gabrielaportomachado/ENGN1600-Project/plots/full_allon.png

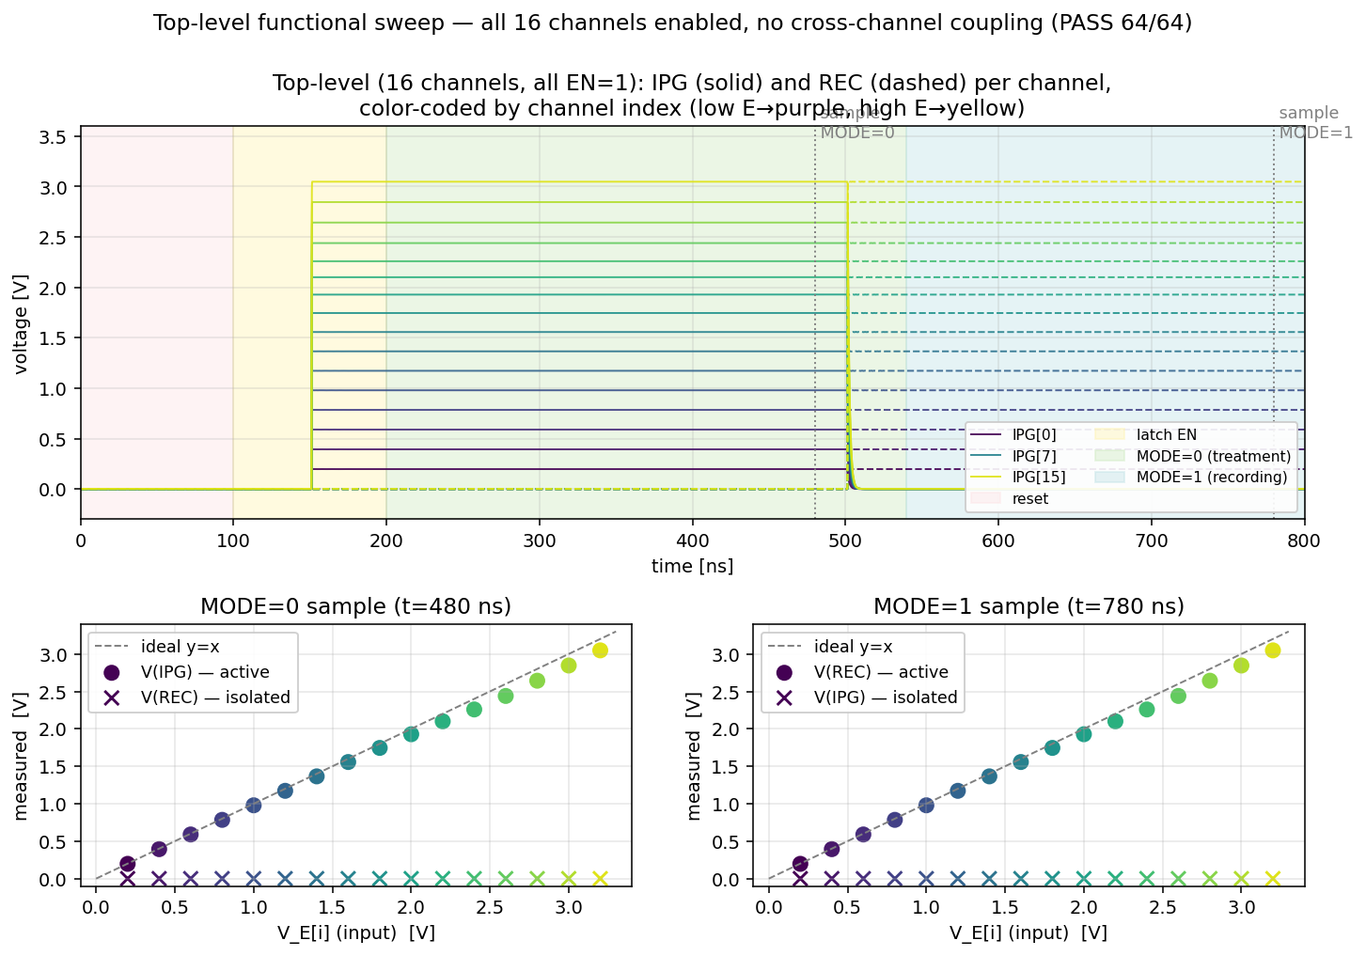
plots/full_allon.png
