gabrielaportomachado/ENGN1600-Project/plots/full_chip.png

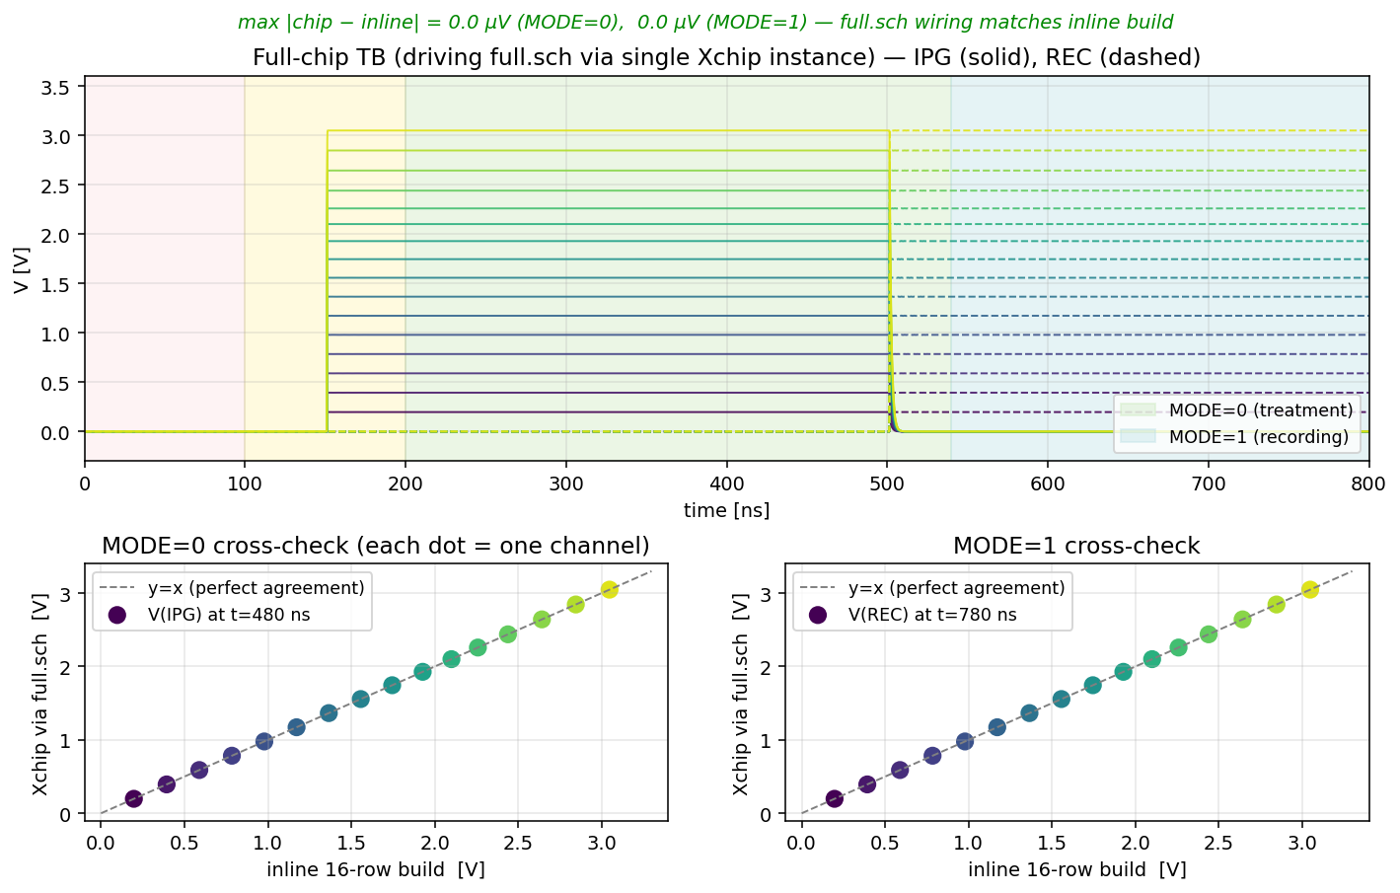
plots/full_chip.png
