gabrielaportomachado/ENGN1600-Project/plots/pex_compare.png

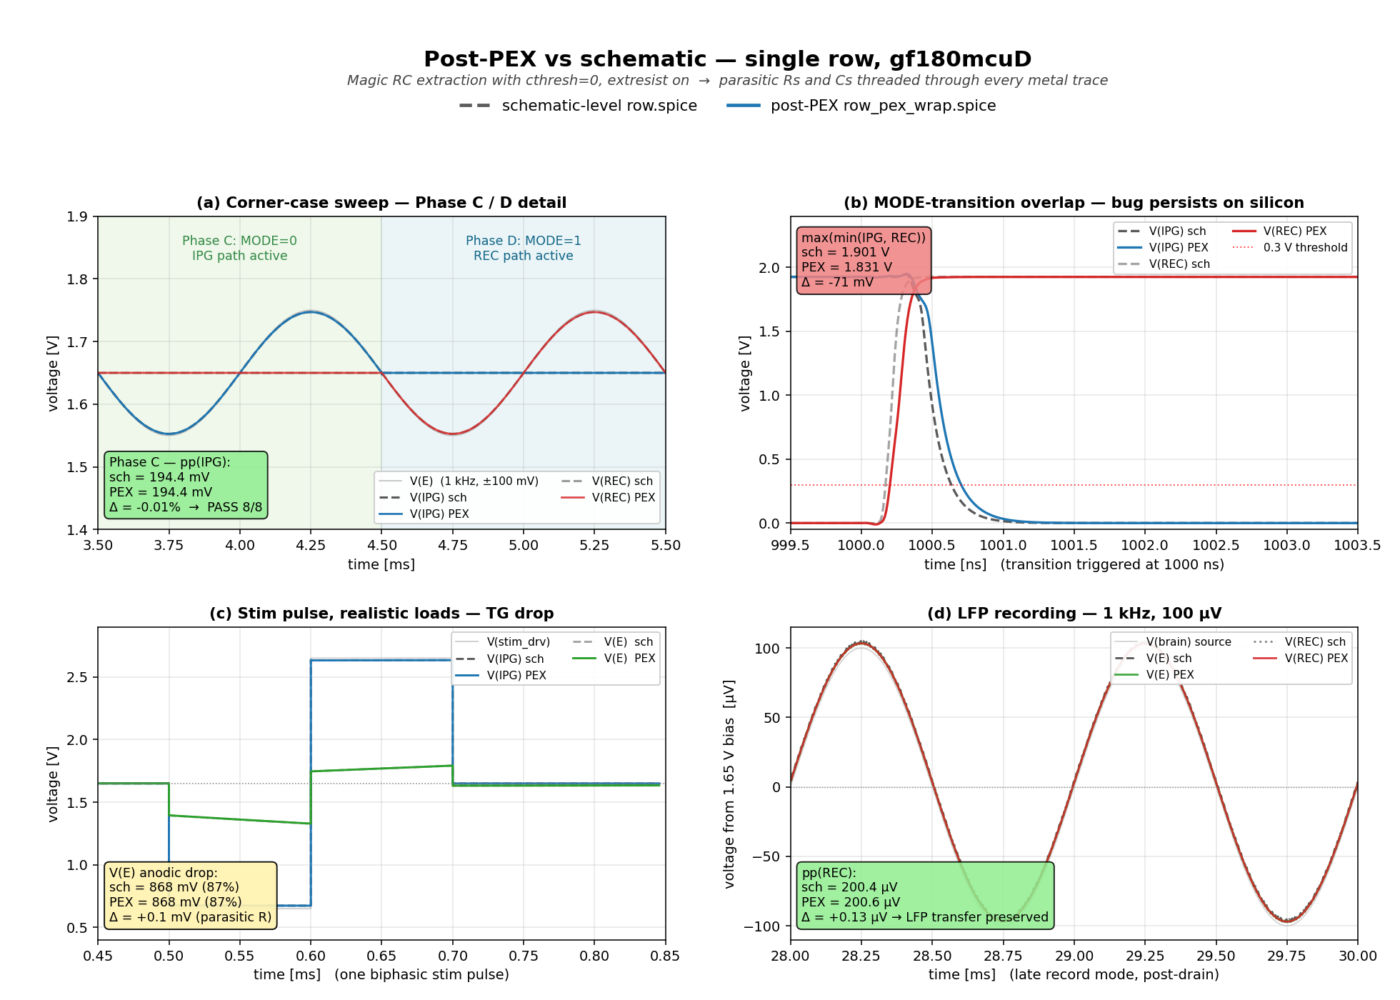
plots/pex_compare.png
