gabrielaportomachado/ENGN1600-Project/plots/randles_model.png

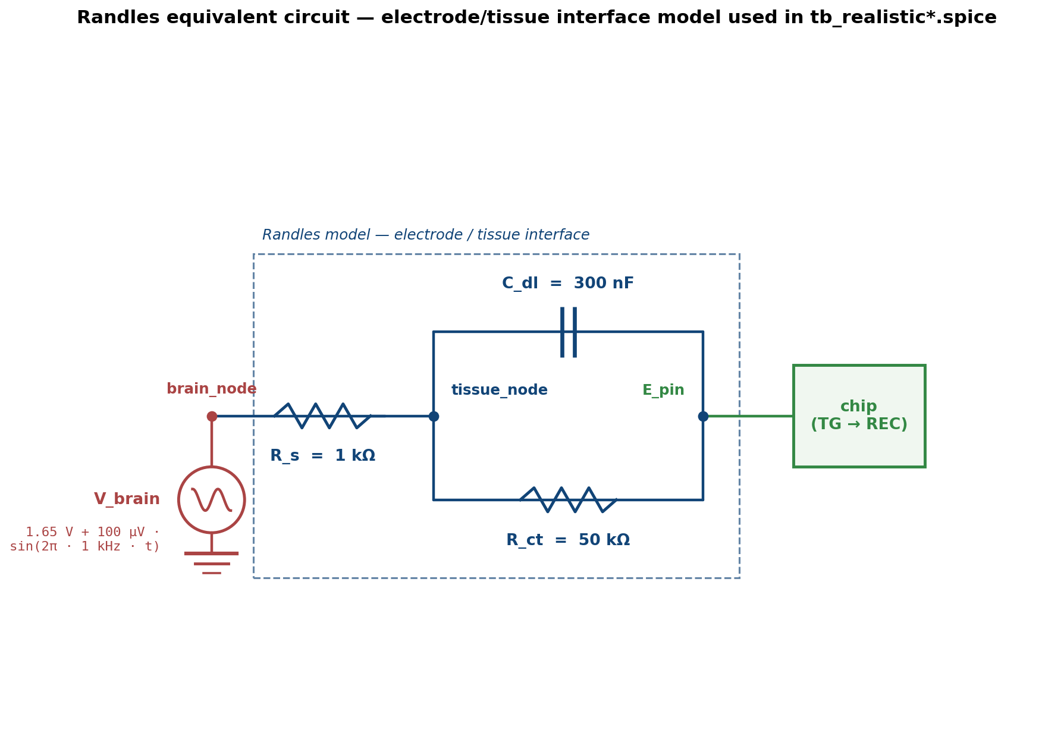
plots/randles_model.png
