gabrielaportomachado/ENGN1600-Project/plots/realistic.png

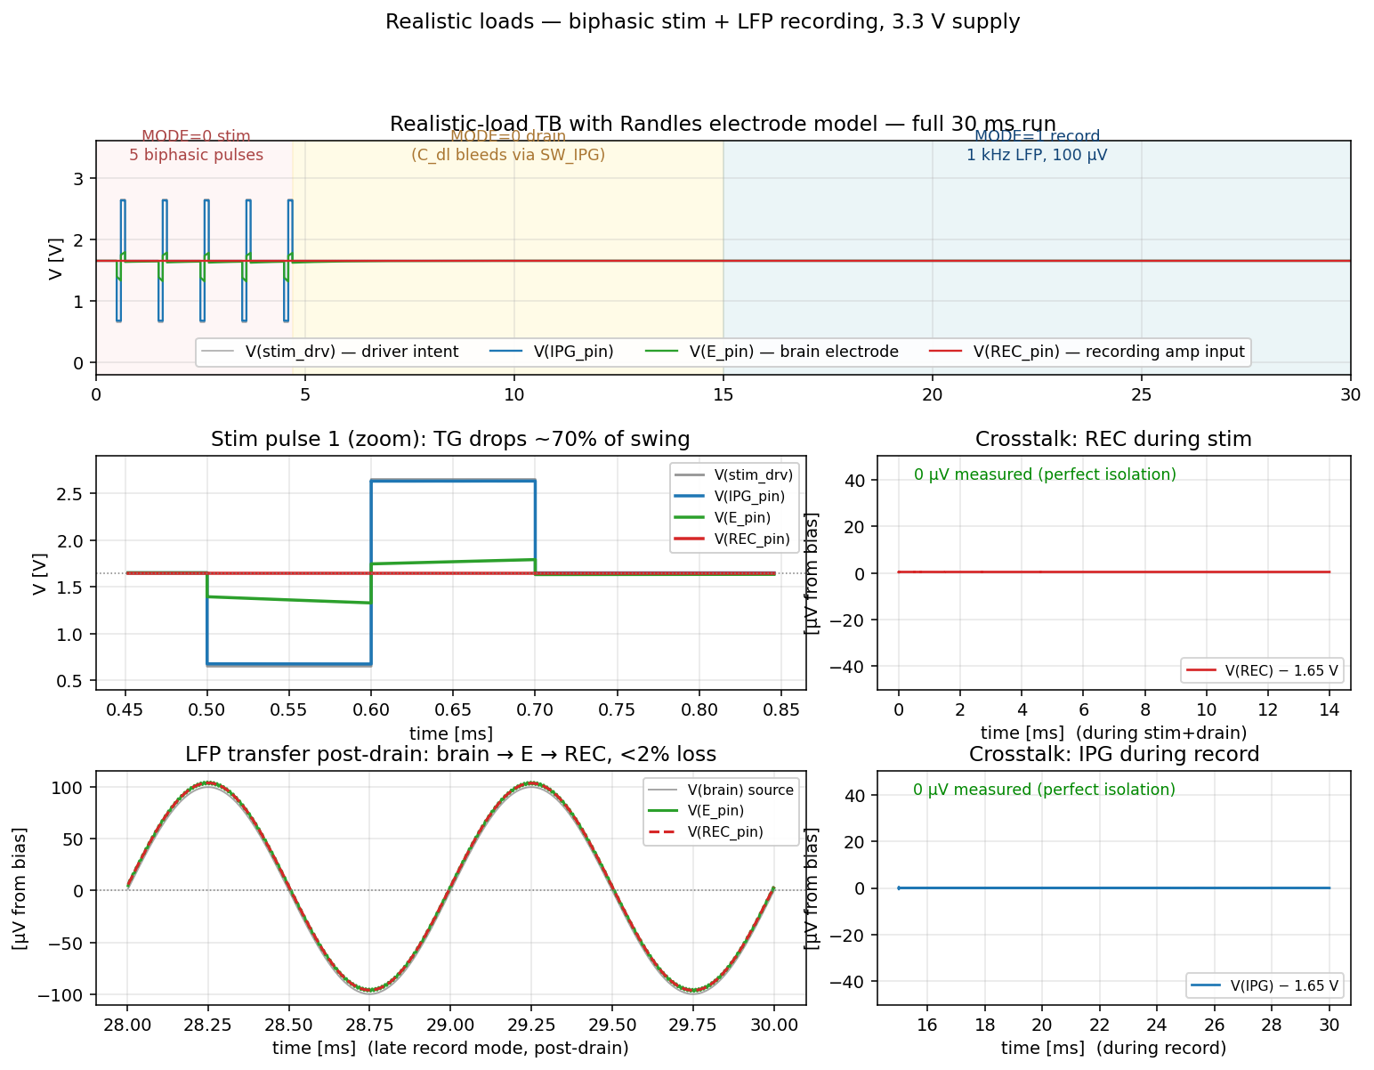
plots/realistic.png
