gabrielaportomachado/ENGN1600-Project/plots/row_corners.png

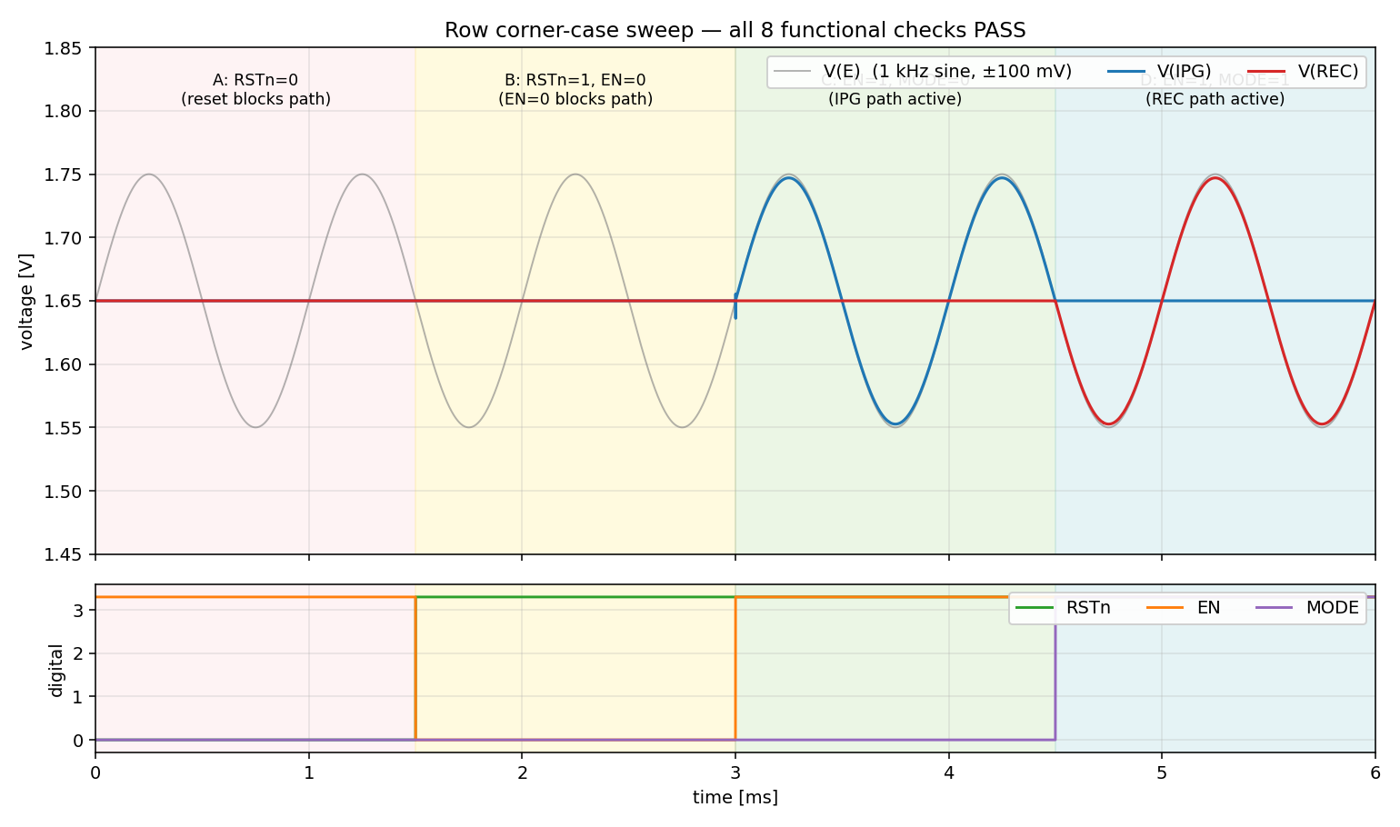
plots/row_corners.png
