gabrielaportomachado/ENGN1600-Project/plots/row_overlap.png

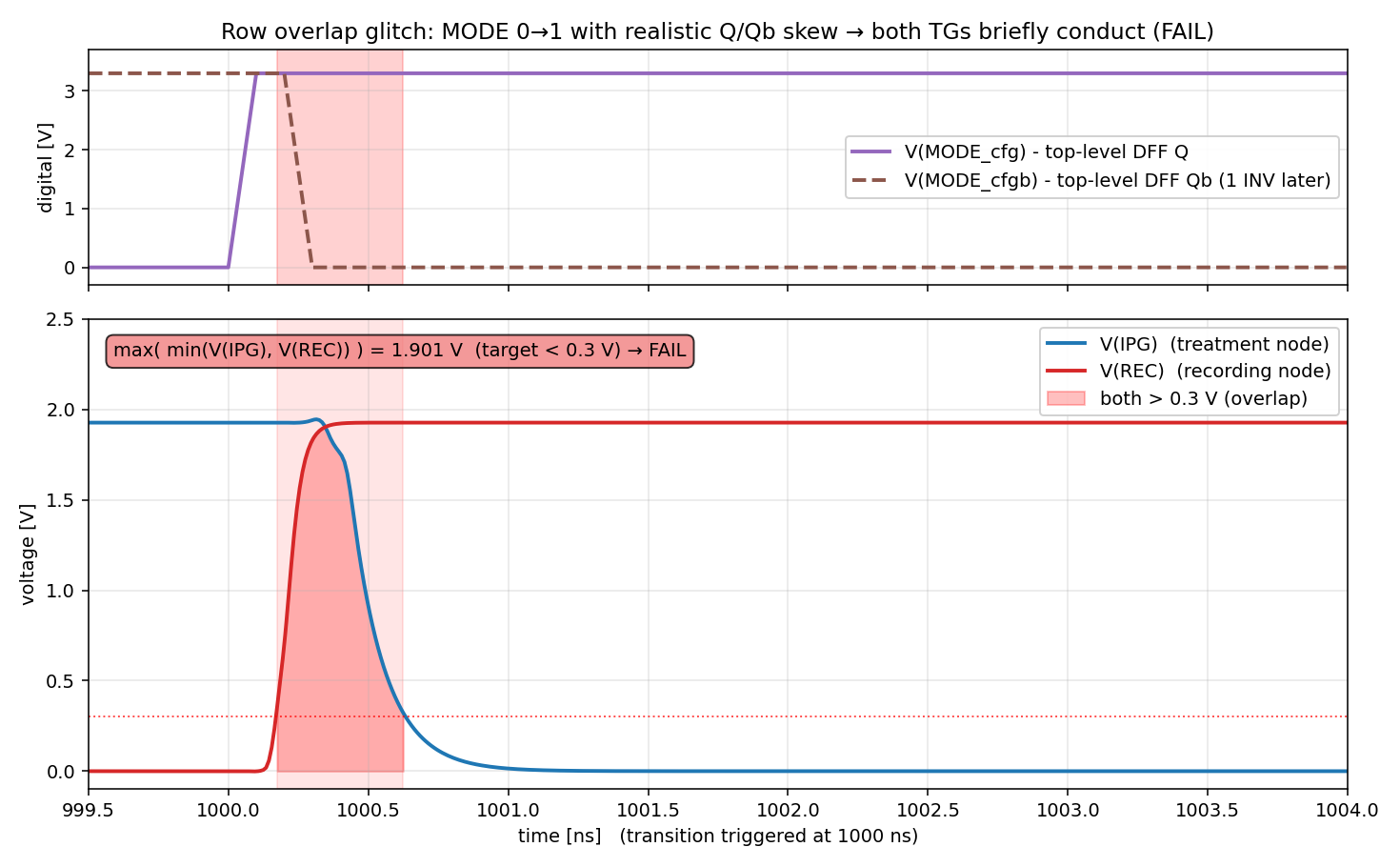
plots/row_overlap.png
