gabrielaportomachado/ENGN1600-Project/plots/row_overlap_compare.png

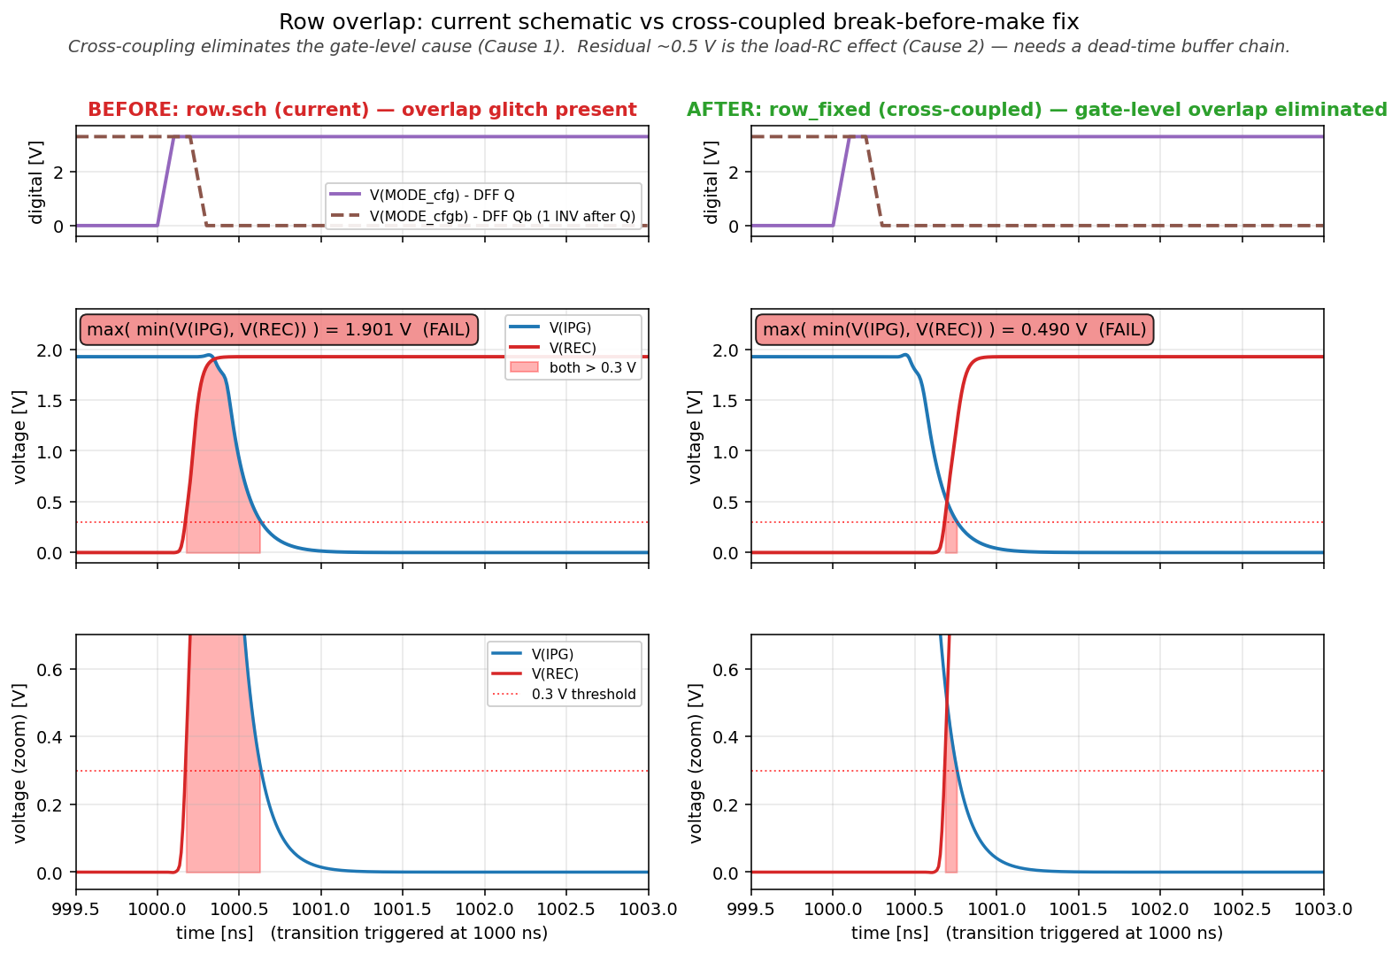
plots/row_overlap_compare.png
