gabrielaportomachado/ENGN1600-Project/plots/slide_row_fixed_dt_overlap.png

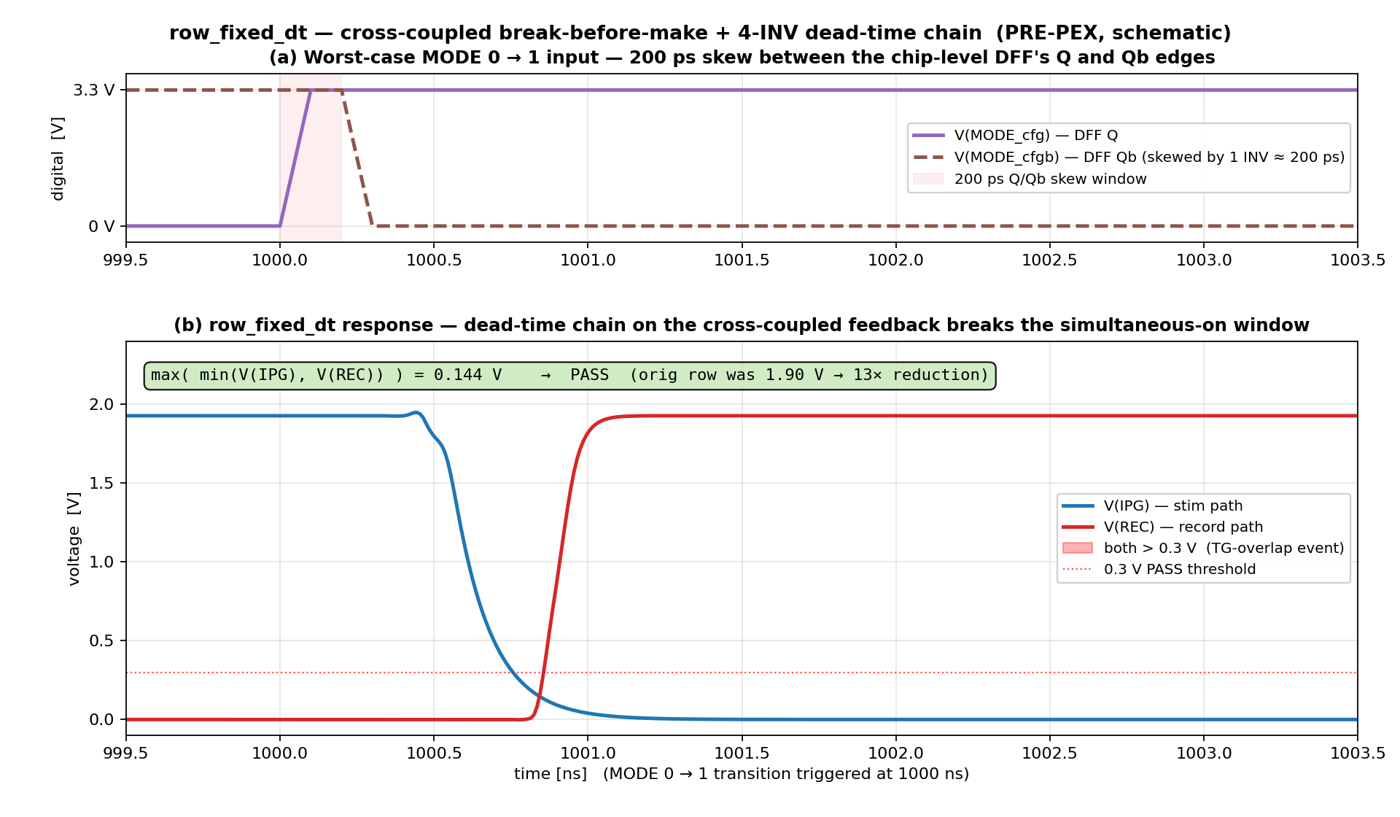
plots/slide_row_fixed_dt_overlap.png
