gabrielaportomachado/ENGN1600-Project/plots/slide_row_pex.png

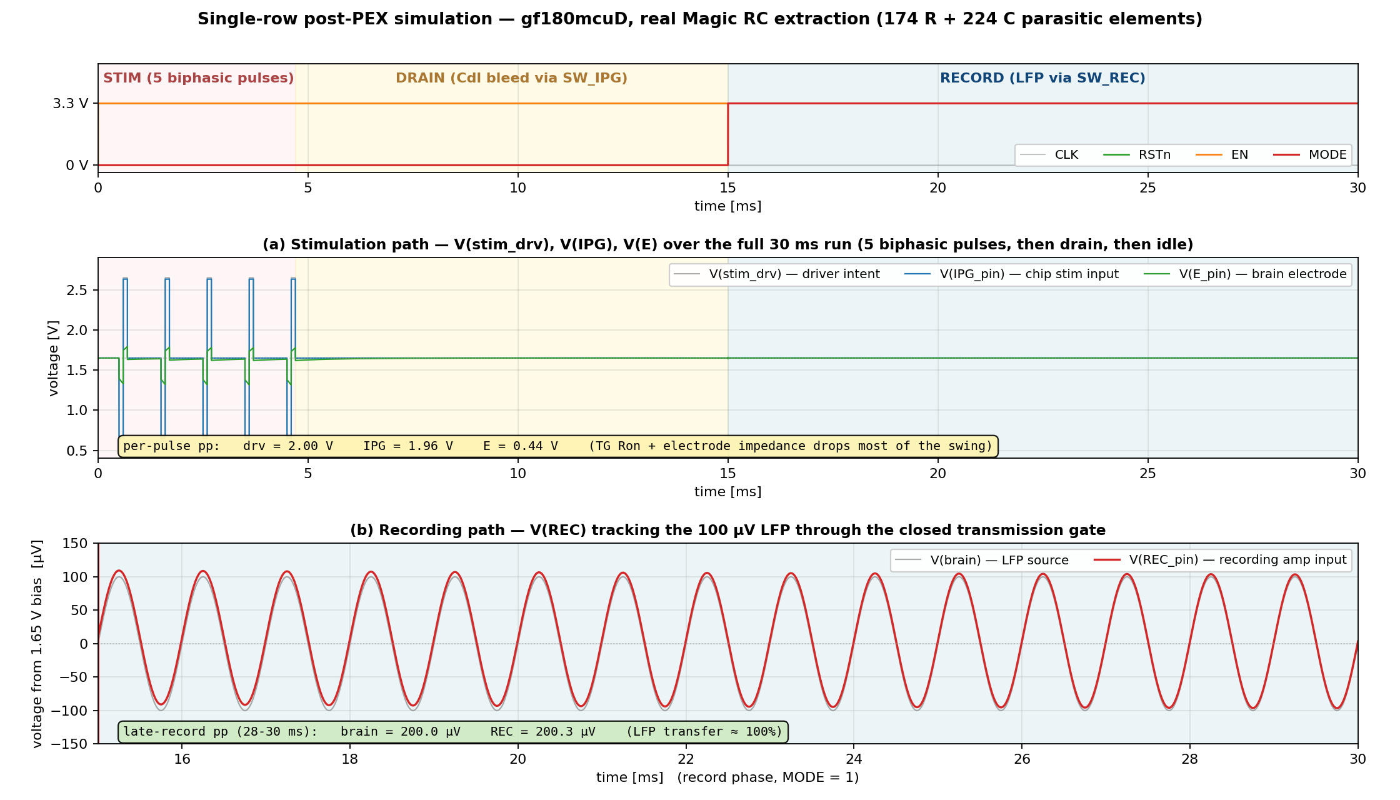
plots/slide_row_pex.png
