gabrielaportomachado/ENGN1600-Project/plots/tgate_hiz.png

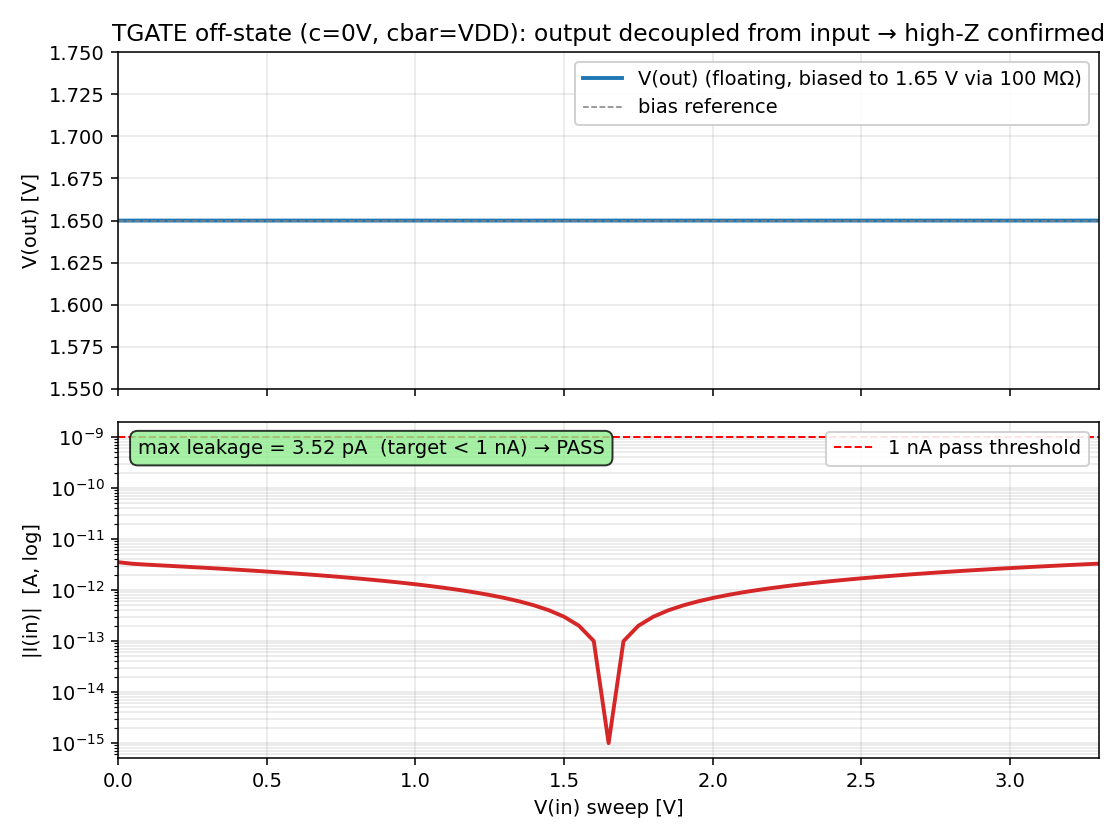
plots/tgate_hiz.png
