gabrielaportomachado/ENGN1600-Project/FULL_extracted.cir

* Extracted by KLayout with GF180MCU LVS runset on : 08/05/2026 13:20

.SUBCKT FULL VDD E15 REC15 RSTN EN15 CLK GND IPG15 EN14 E14 REC14 IPG14 EN13
+ E13 REC13 IPG13 EN12 E12 REC12 IPG12 EN11 E11 REC11 IPG11 EN10 E10 REC10
+ IPG10 EN9 E9 REC9 IPG9 MODE EN8 E8 REC8 IPG8 EN7 E7 REC7 IPG7 EN6 E6 REC6
+ IPG6 E5 REC5 EN5 IPG5 EN4 E4 REC4 IPG4 E3 REC3 EN3 IPG3 EN2 E2 REC2 IPG2 EN1
+ E1 REC1 IPG1 EN0 E0 REC0 IPG0
M$1 \$8 \$7 VDD VDD pfet_03v3 L=0.28U W=1U AS=0.65P AD=0.42P PS=3.3U PD=1.84U
M$2 VDD \$20 \$8 VDD pfet_03v3 L=0.28U W=1U AS=0.42P AD=0.735P PS=1.84U PD=2.47U
M$3 \$9 \$8 VDD VDD pfet_03v3 L=0.28U W=1U AS=0.735P AD=0.635P PS=2.47U PD=3.27U
M$4 \$10 \$9 VDD VDD pfet_03v3 L=0.28U W=1U AS=0.55P AD=0.65P PS=3.1U PD=3.3U
M$5 REC15 \$10 E15 VDD pfet_03v3 L=0.28U W=1U AS=0.65P AD=0.65P PS=3.3U PD=3.3U
M$6 \$3 \$13 VDD VDD pfet_03v3 L=0.28U W=1U AS=0.76P AD=0.65P PS=3.52U PD=3.3U
M$7 VDD \$3 \$4 VDD pfet_03v3 L=0.28U W=1U AS=0.65P AD=0.65P PS=3.3U PD=3.3U
M$8 \$4 RSTN VDD VDD pfet_03v3 L=0.28U W=1U AS=0.65P AD=0.65P PS=3.3U PD=3.3U
M$9 \$13 \$2 \$4 VDD pfet_03v3 L=0.28U W=1U AS=0.65P AD=0.59P PS=3.3U PD=3.18U
M$10 \$5 EN15 \$13 VDD pfet_03v3 L=0.28U W=1U AS=0.63P AD=0.605P PS=3.26U
+ PD=3.21U
M$11 VDD \$15 \$5 VDD pfet_03v3 L=0.28U W=1U AS=0.63P AD=0.54P PS=3.26U PD=3.08U
M$12 VDD \$2 \$15 VDD pfet_03v3 L=0.28U W=1U AS=0.63P AD=0.64P PS=3.26U PD=3.28U
M$13 VDD CLK \$2 VDD pfet_03v3 L=0.28U W=1U AS=0.65P AD=0.65P PS=3.3U PD=3.3U
M$14 \$6 \$19 VDD VDD pfet_03v3 L=0.28U W=1U AS=0.65P AD=0.42P PS=3.3U PD=1.84U
M$15 VDD \$18 \$6 VDD pfet_03v3 L=0.28U W=1U AS=0.42P AD=0.735P PS=1.84U
+ PD=2.47U
M$16 \$7 \$6 VDD VDD pfet_03v3 L=0.28U W=1U AS=0.735P AD=0.64P PS=2.47U PD=3.28U
M$17 \$51 \$2 \$3 VDD pfet_03v3 L=0.28U W=1U AS=0.65P AD=0.65P PS=3.3U PD=3.3U
M$18 \$53 RSTN VDD VDD pfet_03v3 L=0.28U W=1U AS=0.65P AD=0.65P PS=3.3U PD=3.3U
M$19 \$53 \$51 VDD VDD pfet_03v3 L=0.28U W=1U AS=0.65P AD=0.65P PS=3.3U PD=3.3U
M$20 \$78 \$53 \$51 VDD pfet_03v3 L=0.28U W=1U AS=0.65P AD=0.65P PS=3.3U PD=3.3U
M$21 VDD \$15 \$78 VDD pfet_03v3 L=0.28U W=1U AS=0.65P AD=0.65P PS=3.3U PD=3.3U
M$22 \$18 \$53 VDD VDD pfet_03v3 L=0.28U W=1U AS=0.65P AD=0.65P PS=3.3U PD=3.3U
M$23 \$55 \$53 VDD VDD pfet_03v3 L=0.28U W=1U AS=0.65P AD=0.65P PS=3.3U PD=3.3U
M$24 \$56 \$55 VDD VDD pfet_03v3 L=0.28U W=1U AS=0.65P AD=0.65P PS=3.3U PD=3.3U
M$25 \$57 \$60 VDD VDD pfet_03v3 L=0.28U W=1U AS=0.65P AD=0.42P PS=3.3U PD=1.84U
M$26 VDD \$18 \$57 VDD pfet_03v3 L=0.28U W=1U AS=0.42P AD=0.735P PS=1.84U
+ PD=2.47U
M$27 \$61 \$57 VDD VDD pfet_03v3 L=0.28U W=1U AS=0.735P AD=0.63P PS=2.47U
+ PD=3.26U
M$28 \$58 \$61 VDD VDD pfet_03v3 L=0.28U W=1U AS=0.65P AD=0.42P PS=3.3U PD=1.84U
M$29 VDD \$10 \$58 VDD pfet_03v3 L=0.28U W=1U AS=0.42P AD=0.735P PS=1.84U
+ PD=2.47U
M$30 \$62 \$58 VDD VDD pfet_03v3 L=0.28U W=1U AS=0.735P AD=0.63P PS=2.47U
+ PD=3.26U
M$31 \$20 \$62 VDD VDD pfet_03v3 L=0.28U W=1U AS=0.56P AD=0.65P PS=3.12U PD=3.3U
M$32 IPG15 \$20 E15 VDD pfet_03v3 L=0.28U W=1U AS=0.65P AD=0.65P PS=3.3U PD=3.3U
M$33 \$93 \$92 VDD VDD pfet_03v3 L=0.28U W=1U AS=0.76P AD=0.65P PS=3.52U PD=3.3U
M$34 VDD \$93 \$94 VDD pfet_03v3 L=0.28U W=1U AS=0.65P AD=0.65P PS=3.3U PD=3.3U
M$35 \$94 RSTN VDD VDD pfet_03v3 L=0.28U W=1U AS=0.65P AD=0.65P PS=3.3U PD=3.3U
M$36 \$92 \$91 \$94 VDD pfet_03v3 L=0.28U W=1U AS=0.65P AD=0.59P PS=3.3U
+ PD=3.18U
M$37 \$96 EN14 \$92 VDD pfet_03v3 L=0.28U W=1U AS=0.63P AD=0.605P PS=3.26U
+ PD=3.21U
M$38 VDD \$97 \$96 VDD pfet_03v3 L=0.28U W=1U AS=0.63P AD=0.54P PS=3.26U
+ PD=3.08U
M$39 VDD \$91 \$97 VDD pfet_03v3 L=0.28U W=1U AS=0.63P AD=0.64P PS=3.26U
+ PD=3.28U
M$40 VDD CLK \$91 VDD pfet_03v3 L=0.28U W=1U AS=0.65P AD=0.65P PS=3.3U PD=3.3U
M$41 \$98 \$19 VDD VDD pfet_03v3 L=0.28U W=1U AS=0.65P AD=0.42P PS=3.3U PD=1.84U
M$42 VDD \$99 \$98 VDD pfet_03v3 L=0.28U W=1U AS=0.42P AD=0.735P PS=1.84U
+ PD=2.47U
M$43 \$100 \$98 VDD VDD pfet_03v3 L=0.28U W=1U AS=0.735P AD=0.64P PS=2.47U
+ PD=3.28U
M$44 \$101 \$100 VDD VDD pfet_03v3 L=0.28U W=1U AS=0.65P AD=0.42P PS=3.3U
+ PD=1.84U
M$45 VDD \$102 \$101 VDD pfet_03v3 L=0.28U W=1U AS=0.42P AD=0.735P PS=1.84U
+ PD=2.47U
M$46 \$103 \$101 VDD VDD pfet_03v3 L=0.28U W=1U AS=0.735P AD=0.635P PS=2.47U
+ PD=3.27U
M$47 \$104 \$103 VDD VDD pfet_03v3 L=0.28U W=1U AS=0.55P AD=0.65P PS=3.1U
+ PD=3.3U
M$48 REC14 \$104 E14 VDD pfet_03v3 L=0.28U W=1U AS=0.65P AD=0.65P PS=3.3U
+ PD=3.3U
M$49 \$136 \$91 \$93 VDD pfet_03v3 L=0.28U W=1U AS=0.65P AD=0.65P PS=3.3U
+ PD=3.3U
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
+ PD=3.18U
M$341 \$907 EN5 \$902 VDD pfet_03v3 L=0.28U W=1U AS=0.63P AD=0.605P PS=3.26U
+ PD=3.21U
M$342 VDD \$905 \$907 VDD pfet_03v3 L=0.28U W=1U AS=0.63P AD=0.54P PS=3.26U
+ PD=3.08U
M$343 VDD \$896 \$905 VDD pfet_03v3 L=0.28U W=1U AS=0.63P AD=0.64P PS=3.26U
+ PD=3.28U
M$344 VDD CLK \$896 VDD pfet_03v3 L=0.28U W=1U AS=0.65P AD=0.65P PS=3.3U PD=3.3U
M$345 \$909 \$19 VDD VDD pfet_03v3 L=0.28U W=1U AS=0.65P AD=0.42P PS=3.3U
+ PD=1.84U
M$346 VDD \$908 \$909 VDD pfet_03v3 L=0.28U W=1U AS=0.42P AD=0.735P PS=1.84U
+ PD=2.47U
M$347 \$910 \$909 VDD VDD pfet_03v3 L=0.28U W=1U AS=0.735P AD=0.64P PS=2.47U
+ PD=3.28U
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
