gabrielaportomachado/ENGN1600-Project/SPICE/full_pex.spice

* NGSPICE file created from FULL.ext - technology: gf180mcuD

.subckt AND$2 a_n912_n1080# a_n1108_n1500# w_n898_n1046# a_n962_n1500# a_n206_n1400#
+ a_n966_n984# a_n359_n1400# a_n1112_n984# a_n719_n907# a_n780_n1500# w_n324_n1046#
+ w_n674_n1046# a_n688_n1202#
X0 a_n719_n907# a_n688_n1202# a_n780_n1500# a_n1108_n1500# nfet_03v3 ad=0.65p pd=3.3u as=0.42p ps=1.84u w=1u l=0.28u
X1 a_n780_n1500# a_n912_n1080# a_n962_n1500# a_n1108_n1500# nfet_03v3 ad=0.42p pd=1.84u as=0.63p ps=3.26u w=1u l=0.28u
X2 a_n1108_n1500# a_n719_n907# a_n359_n1400# a_n1108_n1500# nfet_03v3 ad=0.31p pd=2.24u as=0.2425p ps=1.97u w=0.5u l=0.28u
C0 a_n780_n1500# a_n688_n1202# 0.0047f
C1 a_n719_n907# a_n359_n1400# 0.12036f
C2 a_n912_n1080# a_n719_n907# 0.02475f
C3 a_n912_n1080# w_n898_n1046# 0.06384f
C4 a_n912_n1080# a_n1112_n984# 0
C5 w_n674_n1046# a_n912_n1080# 0.00504f
C6 a_n359_n1400# a_n688_n1202# 0.00215f
C7 a_n780_n1500# a_n962_n1500# 0.00599f
C8 a_n912_n1080# a_n688_n1202# 0.03899f
C9 a_n359_n1400# a_n962_n1500# 0.0074f
C10 a_n912_n1080# a_n962_n1500# 0.01438f
C11 a_n780_n1500# a_n359_n1400# 0.00123f
C12 a_n719_n907# w_n898_n1046# 0.00889f
C13 a_n719_n907# a_n1112_n984# 0.00206f
C14 w_n674_n1046# a_n719_n907# 0.02349f
C15 a_n719_n907# a_n688_n1202# 0.13145f
C16 w_n898_n1046# a_n688_n1202# 0.00418f
C17 w_n674_n1046# a_n688_n1202# 0.04973f
C18 a_n719_n907# w_n324_n1046# 0.06116f
C19 a_n912_n1080# a_n359_n1400# 0
C20 w_n324_n1046# a_n688_n1202# 0.00144f
C21 a_n719_n907# a_n962_n1500# 0.01277f
C22 a_n719_n907# a_n780_n1500# 0.01043f
C23 a_n962_n1500# a_n688_n1202# 0.00216f
C24 a_n359_n1400# a_n1108_n1500# 0.10054f
C25 a_n962_n1500# a_n1108_n1500# 0.15217f
C26 a_n719_n907# a_n1108_n1500# 0.73548f
C27 a_n688_n1202# a_n1108_n1500# 0.34773f
C28 a_n1112_n984# a_n1108_n1500# 0.26053f
C29 a_n912_n1080# a_n1108_n1500# 0.38694f
C30 w_n324_n1046# a_n1108_n1500# 0.19084f
C31 w_n674_n1046# a_n1108_n1500# 0.1813f
C32 w_n898_n1046# a_n1108_n1500# 0.18473f
.ends

.subckt AND$3 w_46_265# w_n528_265# a_n742_327# w_n304_265# a_n542_231# a_n318_109#
+ a_n738_n189# a_164_n89# a_n592_n189# a_n349_404# a_11_n89# a_n410_n189#
X0 a_n738_n189# a_n349_404# a_11_n89# a_n738_n189# nfet_03v3 ad=0.315p pd=2.26u as=0.2425p ps=1.97u w=0.5u l=0.28u
X1 a_n410_n189# a_n542_231# a_n592_n189# a_n738_n189# nfet_03v3 ad=0.42p pd=1.84u as=0.63p ps=3.26u w=1u l=0.28u
X2 a_n349_404# a_n318_109# a_n410_n189# a_n738_n189# nfet_03v3 ad=0.65p pd=3.3u as=0.42p ps=1.84u w=1u l=0.28u
C0 a_n542_231# w_n528_265# 0.06384f
C1 a_n542_231# a_11_n89# 0
C2 a_n318_109# a_n349_404# 0.13145f
C3 w_n304_265# a_n349_404# 0.02349f
C4 a_n349_404# a_n592_n189# 0.01277f
C5 a_n410_n189# a_n349_404# 0.01043f
C6 a_n349_404# w_n528_265# 0.00889f
C7 a_n318_109# w_n304_265# 0.04973f
C8 a_n318_109# a_n592_n189# 0.00216f
C9 a_n542_231# a_n742_327# 0
C10 a_n349_404# a_11_n89# 0.12036f
C11 a_n318_109# a_n410_n189# 0.0047f
C12 a_n318_109# w_n528_265# 0.00418f
C13 a_n318_109# a_11_n89# 0.00215f
C14 a_n410_n189# a_n592_n189# 0.00599f
C15 a_n349_404# w_46_265# 0.06116f
C16 a_n542_231# a_n349_404# 0.02475f
C17 a_11_n89# a_n592_n189# 0.0074f
C18 a_n318_109# w_46_265# 0.00144f
C19 a_n410_n189# a_11_n89# 0.00123f
C20 a_n318_109# a_n542_231# 0.03899f
C21 w_n304_265# a_n542_231# 0.00504f
C22 a_n349_404# a_n742_327# 0.00206f
C23 a_n542_231# a_n592_n189# 0.01438f
C24 a_11_n89# a_n738_n189# 0.10054f
C25 a_n592_n189# a_n738_n189# 0.15217f
C26 a_n349_404# a_n738_n189# 0.73548f
C27 a_n318_109# a_n738_n189# 0.34773f
C28 a_n742_327# a_n738_n189# 0.26053f
C29 a_n542_231# a_n738_n189# 0.38694f
C30 w_46_265# a_n738_n189# 0.19084f
C31 w_n304_265# a_n738_n189# 0.1813f
C32 w_n528_265# a_n738_n189# 0.18473f
.ends

.subckt ROW a_5675_1286# a_5951_2129# a_9592_2447# a_7247_1286# a_5263_2178# AND$3_0/a_164_n89#
+ a_7247_2178# a_4891_1225# a_5077_2694# AND$2_0/a_n719_n907# AND$2_0/a_n780_n1500#
+ GND a_5675_1802# a_9600_2649# a_7191_1226# a_7247_2694# a_7247_1802#
+ a_6695_1226# a_7821_2278# a_6316_1670# a_9656_2193# a_7191_2118# AND$3_0/a_n410_n189#
+ a_6198_1286# a_9600_1212# a_5315_1802# AND$3_0/a_n349_404# a_4203_1285# a_9470_2709#
+ a_6379_2178# a_9470_1272# a_7821_1286# a_4389_1285# a_7415_2118# a_9656_1272# a_6751_2178#
+ a_4575_1802# a_5619_1226#
XAND$2_0 a_7821_2278# GND GND GND a_9592_2447#
+ GND GND GND AND$2_0/a_n719_n907# AND$2_0/a_n780_n1500#
+ GND GND a_9600_1212# AND$2
XAND$3_0 GND GND GND GND a_7821_1286#
+ a_9600_2649# GND AND$3_0/a_164_n89# GND AND$3_0/a_n349_404#
+ GND AND$3_0/a_n410_n189# AND$3
X0 a_7821_1286# a_7247_1286# GND GND nfet_03v3 ad=0.3125p pd=2.25u as=0.2425p ps=1.97u w=0.5u l=0.28u
X1 VDD a_7415_2118# a_7247_1286# VDD pfet_03v3 ad=0.735p pd=2.47u as=0.42p ps=1.84u w=1u l=0.28u
X2 a_9600_1212# VDD VDD VDD pfet_03v3 ad=0.65p pd=3.3u as=0.55p ps=3.1u w=1u l=0.28u
X3 a_7415_2118# a_5951_2129# GND GND nfet_03v3 ad=0.61p pd=3.22u as=0.61p ps=3.22u w=1u l=0.28u
X4 a_9656_1272# GND a_9470_1272# GND nfet_03v3 ad=0.63p pd=3.26u as=0.63p ps=3.26u w=1u l=0.28u
X5 a_7247_2694# a_7191_2118# VDD VDD pfet_03v3 ad=0.42p pd=1.84u as=0.65p ps=3.3u w=1u l=0.28u
X6 a_4389_1285# a_4891_1225# a_4575_1802# GND nfet_03v3 ad=0.61p pd=3.22u as=0.61p ps=3.22u w=1u l=0.28u
X7 a_9600_1212# GND GND GND nfet_03v3 ad=0.315p pd=2.26u as=0.2825p ps=2.13u w=0.5u l=0.28u
X8 a_5077_2694# a_6316_1670# a_4203_1285# VDD pfet_03v3 ad=0.65p pd=3.3u as=0.65p ps=3.3u w=1u l=0.28u
X9 a_5263_2694# a_5951_2129# a_5077_2694# VDD pfet_03v3 ad=0.65p pd=3.3u as=0.65p ps=3.3u w=1u l=0.28u
X10 a_7247_1286# a_7415_2118# a_7247_1802# GND nfet_03v3 ad=0.65p pd=3.3u as=0.42p ps=1.84u w=1u l=0.28u
X11 VDD a_6695_1226# a_6316_1670# VDD pfet_03v3 ad=0.65p pd=3.3u as=0.65p ps=3.3u w=1u l=0.28u
X12 a_7247_2694# a_7415_2118# a_7247_2178# GND nfet_03v3 ad=0.65p pd=3.3u as=0.42p ps=1.84u w=1u l=0.28u
X13 a_4575_1802# a_4203_1285# GND GND nfet_03v3 ad=0.61p pd=3.22u as=0.61p ps=3.22u w=1u l=0.28u
X14 a_4203_1285# a_5315_1802# VDD VDD pfet_03v3 ad=0.65p pd=3.3u as=0.76p ps=3.52u w=1u l=0.28u
X15 a_6379_2178# a_5951_2129# VDD VDD pfet_03v3 ad=0.65p pd=3.3u as=0.65p ps=3.3u w=1u l=0.28u
X16 VDD a_6316_1670# a_6198_1286# VDD pfet_03v3 ad=0.64p pd=3.28u as=0.63p ps=3.26u w=1u l=0.28u
X17 a_5315_1802# a_6316_1670# a_4389_1285# VDD pfet_03v3 ad=0.59p pd=3.18u as=0.65p ps=3.3u w=1u l=0.28u
X18 a_7247_1286# a_7191_1226# VDD VDD pfet_03v3 ad=0.42p pd=1.84u as=0.65p ps=3.3u w=1u l=0.28u
X19 GND a_6316_1670# a_5675_1802# GND nfet_03v3 ad=0.575p pd=3.15u as=0.61p ps=3.22u w=1u l=0.28u
X20 VDD a_6198_1286# a_5675_1286# VDD pfet_03v3 ad=0.54p pd=3.08u as=0.63p ps=3.26u w=1u l=0.28u
X21 GND a_6695_1226# a_6316_1670# GND nfet_03v3 ad=0.67p pd=3.34u as=0.63p ps=3.26u w=1u l=0.28u
X22 a_5951_2129# a_5077_2694# VDD VDD pfet_03v3 ad=0.65p pd=3.3u as=0.65p ps=3.3u w=1u l=0.28u
X23 a_6751_2178# a_6379_2178# GND GND nfet_03v3 ad=0.61p pd=3.22u as=0.61p ps=3.22u w=1u l=0.28u
X24 a_7821_2278# a_7247_2694# VDD VDD pfet_03v3 ad=0.63p pd=3.26u as=0.735p ps=2.47u w=1u l=0.28u
X25 GND a_6316_1670# a_6198_1286# GND nfet_03v3 ad=0.61p pd=3.22u as=0.61p ps=3.22u w=1u l=0.28u
X26 a_7415_2118# a_5951_2129# VDD VDD pfet_03v3 ad=0.65p pd=3.3u as=0.65p ps=3.3u w=1u l=0.28u
X27 a_5077_2694# a_6198_1286# a_4203_1285# GND nfet_03v3 ad=0.61p pd=3.22u as=0.715p ps=3.43u w=1u l=0.28u
X28 a_7247_2178# a_7191_2118# GND GND nfet_03v3 ad=0.42p pd=1.84u as=0.63p ps=3.26u w=1u l=0.28u
X29 a_7247_1802# a_7191_1226# GND GND nfet_03v3 ad=0.42p pd=1.84u as=0.63p ps=3.26u w=1u l=0.28u
X30 a_4389_1285# a_4891_1225# VDD VDD pfet_03v3 ad=0.65p pd=3.3u as=0.65p ps=3.3u w=1u l=0.28u
X31 a_5951_2129# a_4891_1225# VDD VDD pfet_03v3 ad=0.65p pd=3.3u as=0.65p ps=3.3u w=1u l=0.28u
X32 a_9600_2649# GND GND GND nfet_03v3 ad=0.315p pd=2.26u as=0.285p ps=2.14u w=0.5u l=0.28u
X33 a_5263_2178# a_5951_2129# a_5077_2694# GND nfet_03v3 ad=0.61p pd=3.22u as=0.61p ps=3.22u w=1u l=0.28u
X34 a_5315_1802# a_6198_1286# a_4389_1285# GND nfet_03v3 ad=0.61p pd=3.22u as=0.61p ps=3.22u w=1u l=0.28u
X35 VDD a_4203_1285# a_4389_1285# VDD pfet_03v3 ad=0.65p pd=3.3u as=0.65p ps=3.3u w=1u l=0.28u
X36 a_5675_1286# a_5619_1226# a_5315_1802# VDD pfet_03v3 ad=0.605p pd=3.21u as=0.63p ps=3.26u w=1u l=0.28u
X37 a_7821_2278# a_7247_2694# GND GND nfet_03v3 ad=0.31p pd=2.24u as=0.2425p ps=1.97u w=0.5u l=0.28u
X38 VDD a_7415_2118# a_7247_2694# VDD pfet_03v3 ad=0.735p pd=2.47u as=0.42p ps=1.84u w=1u l=0.28u
X39 a_4518_2178# a_4891_1225# GND GND nfet_03v3 ad=0.61p pd=3.22u as=0.61p ps=3.22u w=1u l=0.28u
X40 a_6379_2178# a_5951_2129# GND GND nfet_03v3 ad=0.61p pd=3.22u as=0.61p ps=3.22u w=1u l=0.28u
X41 a_7821_1286# a_7247_1286# VDD VDD pfet_03v3 ad=0.64p pd=3.28u as=0.735p ps=2.47u w=1u l=0.28u
X42 a_9656_2193# a_9600_2649# a_9470_2709# VDD pfet_03v3 ad=0.65p pd=3.3u as=0.65p ps=3.3u w=1u l=0.28u
X43 a_4203_1285# a_5315_1802# GND GND nfet_03v3 ad=0.61p pd=3.22u as=0.76p ps=3.52u w=1u l=0.28u
X44 a_9656_2193# a_9592_2447# a_9470_2709# GND nfet_03v3 ad=0.63p pd=3.26u as=0.63p ps=3.26u w=1u l=0.28u
X45 VDD a_6198_1286# a_5263_2694# VDD pfet_03v3 ad=0.65p pd=3.3u as=0.65p ps=3.3u w=1u l=0.28u
X46 a_9656_1272# a_9600_1212# a_9470_1272# VDD pfet_03v3 ad=0.65p pd=3.3u as=0.65p ps=3.3u w=1u l=0.28u
X47 a_5675_1802# a_5619_1226# a_5315_1802# GND nfet_03v3 ad=0.61p pd=3.22u as=0.61p ps=3.22u w=1u l=0.28u
X48 a_5951_2129# a_5077_2694# a_4518_2178# GND nfet_03v3 ad=0.61p pd=3.22u as=0.61p ps=3.22u w=1u l=0.28u
X49 GND a_6316_1670# a_5263_2178# GND nfet_03v3 ad=0.61p pd=3.22u as=0.61p ps=3.22u w=1u l=0.28u
X50 a_6751_2178# a_6379_2178# VDD VDD pfet_03v3 ad=0.65p pd=3.3u as=0.65p ps=3.3u w=1u l=0.28u
X51 a_9600_2649# VDD VDD VDD pfet_03v3 ad=0.65p pd=3.3u as=0.56p ps=3.12u w=1u l=0.28u
C0 a_6316_1670# a_5675_1286# 0.04809f
C1 a_6198_1286# a_4389_1285# 0.13561f
C2 a_6198_1286# a_4575_1802# 0.01339f
C3 a_6751_2178# a_5951_2129# 0
C4 AND$3_0/a_n349_404# AND$3_0/a_n410_n189# -0
C5 a_5951_2129# a_4203_1285# 0
C6 a_6316_1670# a_5077_2694# 0.30745f
C7 a_7821_2278# AND$2_0/a_n780_n1500# 0.00196f
C8 a_7191_1226# a_7247_1286# 0.01183f
C9 a_5263_2694# a_5951_2129# 0.01967f
C10 a_4891_1225# a_5077_2694# 0.14366f
C11 a_9600_1212# a_9656_2193# 0
C12 a_6198_1286# a_6695_1226# 0.00134f
C13 a_6695_1226# a_7247_1286# 0.00106f
C14 a_7415_2118# a_5315_1802# 0
C15 a_9600_1212# a_9470_2709# 0
C16 a_7821_2278# AND$2_0/a_n719_n907# 0.02181f
C17 a_9592_2447# a_7247_2694# -0.00321f
C18 a_9592_2447# a_7415_2118# 0
C19 AND$2_0/a_n719_n907# AND$2_0/a_n780_n1500# -0
C20 a_9592_2447# a_9600_1212# 0.07747f
C21 a_4575_1802# a_4389_1285# 0.06846f
C22 a_9600_2649# a_9656_2193# 0.09107f
C23 a_6198_1286# a_5619_1226# 0.03006f
C24 a_5077_2694# a_5263_2178# 0.03003f
C25 a_7247_2694# a_6751_2178# 0.02819f
C26 a_6751_2178# a_7415_2118# 0.06468f
C27 a_9600_2649# a_9470_2709# 0.42f
C28 a_6316_1670# a_6198_1286# 1.05575f
C29 a_5077_2694# a_4518_2178# 0.05591f
C30 a_7247_2694# a_5951_2129# 0
C31 a_9592_2447# a_9600_2649# 0.36682f
C32 a_7415_2118# a_5951_2129# 0.1312f
C33 a_6316_1670# a_7247_1286# 0.02095f
C34 a_6198_1286# a_4891_1225# 0.17522f
C35 a_7191_2118# a_6751_2178# 0.00541f
C36 a_5263_2694# a_7415_2118# 0.00146f
C37 a_5675_1286# a_5315_1802# 0.03043f
C38 a_6316_1670# a_7247_1802# 0
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
C215 a_7821_1286# GND 0.80971f
C216 a_4891_1225# GND 1.07712f
C217 a_6198_1286# GND 1.82747f
C218 a_6316_1670# GND 3.71117f
C219 AND$2_0/a_n780_n1500# GND 0.01212f
C220 AND$2_0/a_n719_n907# GND 0.9387f
C221 a_7821_2278# GND 0.81235f
C222 a_9592_2447# GND 0.63067f
.ends

.subckt AND$3$7 w_46_265# w_n528_265# a_n742_327# w_n304_265# a_n542_231# a_n318_109#
+ a_n738_n189# a_164_n89# a_n592_n189# a_n349_404# a_11_n89# a_n410_n189#
X0 a_n738_n189# a_n349_404# a_11_n89# a_n738_n189# nfet_03v3 ad=0.315p pd=2.26u as=0.2425p ps=1.97u w=0.5u l=0.28u
X1 a_n410_n189# a_n542_231# a_n592_n189# a_n738_n189# nfet_03v3 ad=0.42p pd=1.84u as=0.63p ps=3.26u w=1u l=0.28u
X2 a_n349_404# a_n318_109# a_n410_n189# a_n738_n189# nfet_03v3 ad=0.65p pd=3.3u as=0.42p ps=1.84u w=1u l=0.28u
C0 a_n318_109# w_n528_265# 0.00418f
C1 a_n742_327# a_n349_404# 0.00206f
C2 w_n528_265# a_n542_231# 0.06384f
C3 a_n410_n189# a_n349_404# 0.01043f
C4 a_n592_n189# a_n318_109# 0.00216f
C5 a_n592_n189# a_n542_231# 0.01438f
C6 a_n410_n189# a_11_n89# 0.00123f
C7 a_n318_109# a_n349_404# 0.13145f
C8 a_n349_404# a_n542_231# 0.02475f
C9 a_n318_109# a_11_n89# 0.00215f
C10 a_n318_109# w_46_265# 0.00144f
C11 a_11_n89# a_n542_231# 0
C12 a_n318_109# w_n304_265# 0.04973f
C13 w_n528_265# a_n349_404# 0.00889f
C14 w_n304_265# a_n542_231# 0.00504f
C15 a_n592_n189# a_n349_404# 0.01277f
C16 a_n592_n189# a_11_n89# 0.0074f
C17 a_11_n89# a_n349_404# 0.12036f
C18 w_46_265# a_n349_404# 0.06116f
C19 w_n304_265# a_n349_404# 0.02349f
C20 a_n742_327# a_n542_231# 0
C21 a_n410_n189# a_n318_109# 0.0047f
C22 a_n318_109# a_n542_231# 0.03899f
C23 a_n592_n189# a_n410_n189# 0.00599f
C24 a_11_n89# a_n738_n189# 0.10054f
C25 a_n592_n189# a_n738_n189# 0.15217f
C26 a_n349_404# a_n738_n189# 0.73548f
C27 a_n318_109# a_n738_n189# 0.34773f
C28 a_n742_327# a_n738_n189# 0.26053f
C29 a_n542_231# a_n738_n189# 0.38694f
C30 w_46_265# a_n738_n189# 0.19084f
C31 w_n304_265# a_n738_n189# 0.1813f
C32 w_n528_265# a_n738_n189# 0.18473f
.ends

.subckt AND$2$7 a_n912_n1080# a_n1108_n1500# w_n898_n1046# a_n962_n1500# a_n206_n1400#
+ a_n966_n984# a_n359_n1400# a_n1112_n984# a_n719_n907# a_n780_n1500# w_n324_n1046#
+ w_n674_n1046# a_n688_n1202#
X0 a_n719_n907# a_n688_n1202# a_n780_n1500# a_n1108_n1500# nfet_03v3 ad=0.65p pd=3.3u as=0.42p ps=1.84u w=1u l=0.28u
X1 a_n780_n1500# a_n912_n1080# a_n962_n1500# a_n1108_n1500# nfet_03v3 ad=0.42p pd=1.84u as=0.63p ps=3.26u w=1u l=0.28u
X2 a_n1108_n1500# a_n719_n907# a_n359_n1400# a_n1108_n1500# nfet_03v3 ad=0.31p pd=2.24u as=0.2425p ps=1.97u w=0.5u l=0.28u
C0 a_n912_n1080# w_n898_n1046# 0.06384f
C1 w_n674_n1046# a_n912_n1080# 0.00504f
C2 a_n688_n1202# a_n912_n1080# 0.03899f
C3 a_n962_n1500# a_n359_n1400# 0.0074f
C4 a_n359_n1400# a_n780_n1500# 0.00123f
C5 a_n688_n1202# a_n359_n1400# 0.00215f
C6 a_n719_n907# a_n1112_n984# 0.00206f
C7 w_n324_n1046# a_n719_n907# 0.06116f
C8 a_n962_n1500# a_n719_n907# 0.01277f
C9 a_n719_n907# a_n780_n1500# 0.01043f
C10 a_n359_n1400# a_n912_n1080# 0
C11 a_n719_n907# w_n898_n1046# 0.00889f
C12 w_n674_n1046# a_n719_n907# 0.02349f
C13 a_n688_n1202# a_n719_n907# 0.13145f
C14 a_n688_n1202# w_n324_n1046# 0.00144f
C15 a_n962_n1500# a_n780_n1500# 0.00599f
C16 a_n688_n1202# a_n962_n1500# 0.00216f
C17 a_n688_n1202# a_n780_n1500# 0.0047f
C18 a_n912_n1080# a_n1112_n984# 0
C19 a_n688_n1202# w_n898_n1046# 0.00418f
C20 a_n688_n1202# w_n674_n1046# 0.04973f
C21 a_n912_n1080# a_n719_n907# 0.02475f
C22 a_n359_n1400# a_n719_n907# 0.12036f
C23 a_n962_n1500# a_n912_n1080# 0.01438f
C24 a_n359_n1400# a_n1108_n1500# 0.10054f
C25 a_n962_n1500# a_n1108_n1500# 0.15217f
C26 a_n719_n907# a_n1108_n1500# 0.73548f
C27 a_n688_n1202# a_n1108_n1500# 0.34773f
C28 a_n1112_n984# a_n1108_n1500# 0.26053f
C29 a_n912_n1080# a_n1108_n1500# 0.38694f
C30 w_n324_n1046# a_n1108_n1500# 0.19084f
C31 w_n674_n1046# a_n1108_n1500# 0.1813f
C32 w_n898_n1046# a_n1108_n1500# 0.18473f
.ends
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
