gabrielaportomachado/ENGN1600-Project/(commit log)

2026-04-22 partially done ROW.gds
    [full.sch]
2026-04-22 row fixed
    [full.sch]
2026-04-24 row tb
    [row_tb.sch]
2026-05-05 add better and mroe realistic tbs
    [row_fixed.sch, row_fixed_dt.sch, tb_full_allon.sch, tb_realistic.sch, tb_row_corners.sch, tb_row_overlap.sch, tb_row_overlap_fixed.sch, tb_row_overlap_fixed_dt.sch]
2026-05-05 create full symbol for use in tb
    [tb_full_chip.sch]
2026-05-07 row_fixed gds working with all IO labels only
    [row_fixed.sch, row_tb.sch]
2026-05-07 row gds fully working
    [row_fixed.sch]
2026-05-07 autogenerate plots for realistic tb
    [tb_realistic.sch]
2026-05-08 realistic postpex
    [tb_realistic_postpex.sch]
2026-05-08 finished full
    [full.sch]
2026-05-08 16 chan realistic prepex
    [row_fixed_dt.sch, tb_realistic.sch, tb_realistic_16ch.sch]
2026-05-08 realistic 16 chan postpex
    [full.sch, tb_realistic_16ch.sch, tb_realistic_16ch_postPEX.sch]
